rhammell/mdd32-bot/mechanical/export/MDD32_Bot-Chasis.stl

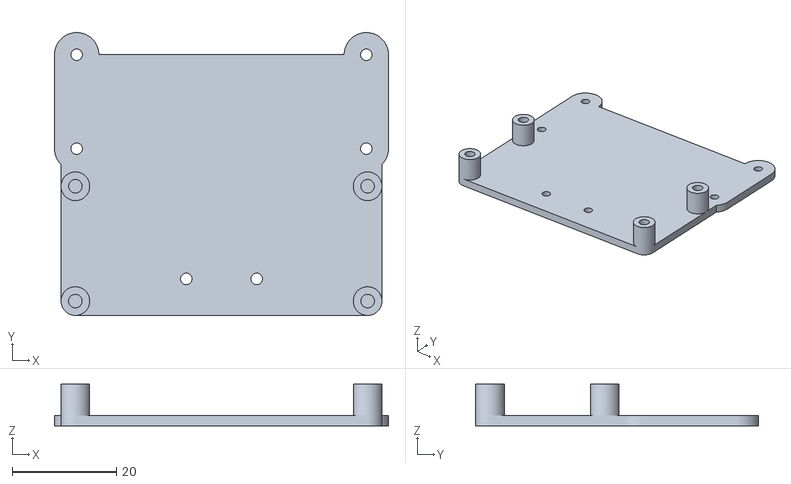
[picture p1: CAD file, 2026-11-05]
mechanical/export/MDD32_Bot-Chasis.stl
64.0 x 54.2 x 8.00
