rhammell/mdd32-bot/mechanical/src/MDD32_Bot.FCStd

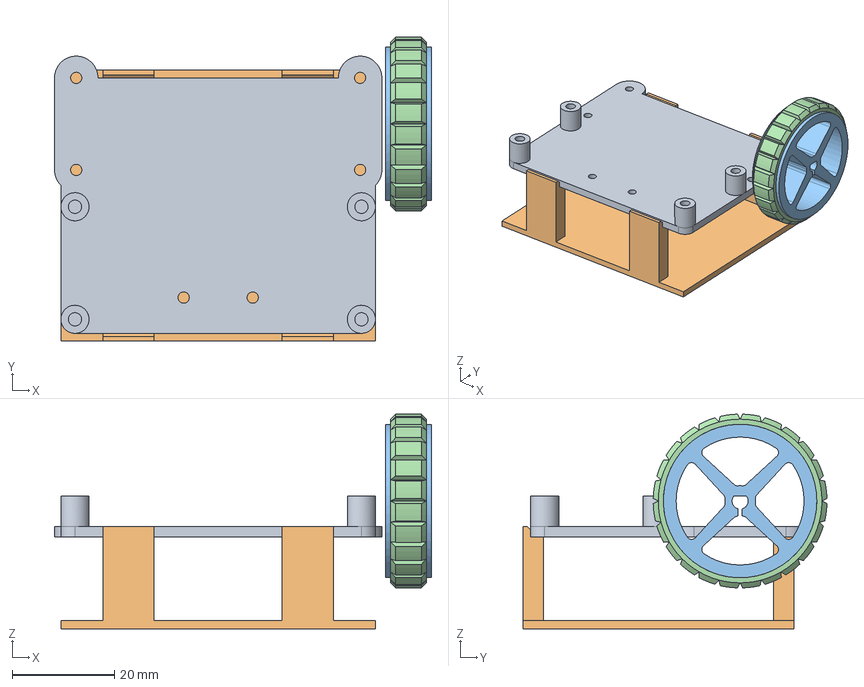
[picture p2: CAD file, 2026-11-05]
mechanical/src/MDD32_Bot.FCStd
73.7 x 59.4 x 42.0 mm
Chasis
Stand
Wheel
Tire
