rhammell/mdd32-bot/mechanical/export/MDD32_Bot-Stand.stl

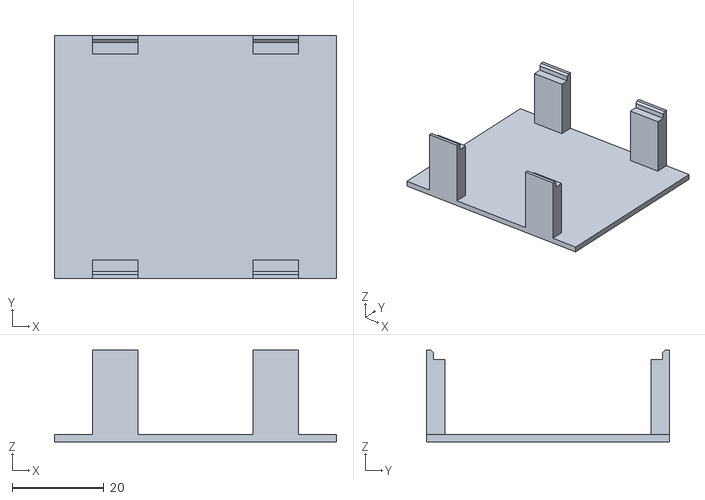
[picture p3: CAD file, 2026-11-05]
mechanical/export/MDD32_Bot-Stand.stl
61.5 x 52.9 x 20.0
