rhammell/mdd32-bot/mechanical/export/MDD32_Bot-Tire.stl

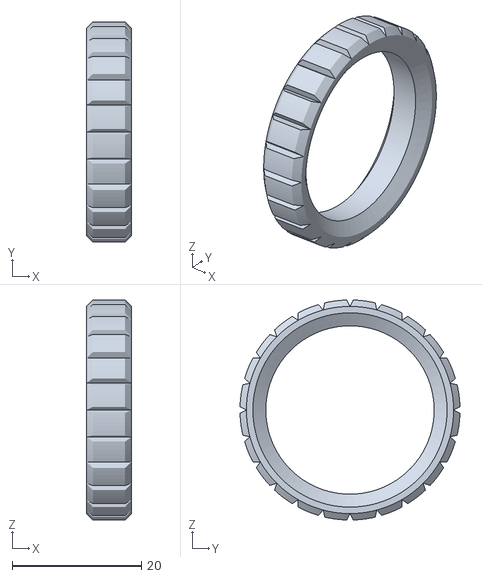
[picture p4: CAD file, 2026-11-05]
mechanical/export/MDD32_Bot-Tire.stl
7.00 x 34.0 x 34.0
