rhammell/mdd32-bot/mechanical/export/MDD32_Bot-Wheel.stl

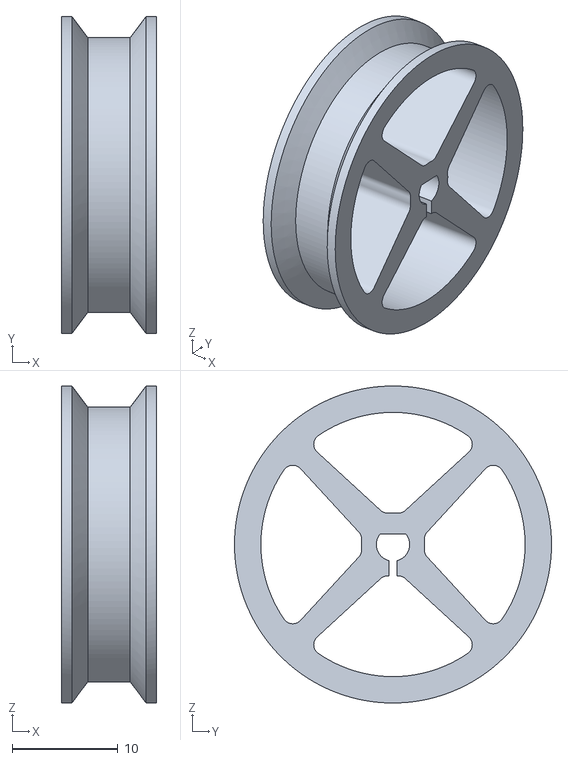
[picture p5: CAD file, 2026-11-05]
mechanical/export/MDD32_Bot-Wheel.stl
9.00 x 30.0 x 30.0
