rhammell/mdd32-bot/firmware/MDD32_Bot/src/drive/MDD32_Drive.cpp

#include "MDD32_Drive.h"

// =============================================================================
// MDD32_Drive Implementation
// =============================================================================

bool MDD32_Drive::begin() {
    // Enable DRV8833 motor driver by pulling nSLEEP high
    Serial.println("[Drive] Enabling DRV8833...");
    pinMode(DRV_SLEEP, OUTPUT);
    digitalWrite(DRV_SLEEP, HIGH);

    // Initialize left motor controller (motor, encoder, PID)
    Serial.println("[Drive] Initializing left motor controller...");
    if (!initController(_leftController,
                        MOT_LEFT_IN1, MOT_LEFT_IN2, MOT_LEFT_FLIP,
                        MOT_LEFT_ENC_A, MOT_LEFT_ENC_B, MOT_LEFT_ENC_FLIP)) {
        Serial.println("[Drive] Left motor controller init FAILED");
        return false;
    }
    Serial.println("[Drive] Left motor controller init OK");

    // Initialize right motor controller (motor, encoder, PID)
    Serial.println("[Drive] Initializing right motor controller...");
    if (!initController(_rightController,
                        MOT_RIGHT_IN1, MOT_RIGHT_IN2, MOT_RIGHT_FLIP,
                        MOT_RIGHT_ENC_A, MOT_RIGHT_ENC_B, MOT_RIGHT_ENC_FLIP)) {
        Serial.println("[Drive] Right motor controller init FAILED");
        return false;
    }
    Serial.println("[Drive] Right motor controller init OK");

    _wheelSyncKP = WHEEL_SYNC_KP;
    _maxAccelRpmS = MAX_ACCEL_RPM_S;

    return true;
}

void MDD32_Drive::setPIDGains(float kp, float ki, float kd) {
    _leftController.setPIDGains(kp, ki, kd);
    _rightController.setPIDGains(kp, ki, kd);
}

void MDD32_Drive::setWheelSyncKP(float kp) {
    _wheelSyncKP = kp;
}

void MDD32_Drive::setMaxAccel(float rpmPerSec) {
    _maxAccelRpmS = rpmPerSec;
}

bool MDD32_Drive::initController(MDD32_Motor_Controller& controller,
                                  uint8_t in1Pin, uint8_t in2Pin, bool motorFlip,
                                  uint8_t encAPin, uint8_t encBPin, bool encFlip) {
    // Config carries only per-side wiring; PID gains and encoder mode are
    // read from robot_definitions.h inside the controller's begin().
    MotorControllerConfig config = {
        in1Pin, in2Pin, motorFlip,
        encAPin, encBPin, encFlip
    };
    return controller.begin(config);
}

void MDD32_Drive::straight(float speed_cm_s) {
    // Both wheels drive the same direction (translate)
    startMove(speed_cm_s, DriveMode::Straight);
}

void MDD32_Drive::spin(float speed_cm_s) {
    // Wheels drive equal-and-opposite so the robot rotates in place about its
    // center. speed_cm_s is the tangential speed of each wheel; positive
    // spins clockwise (left wheel forward, right wheel backward).
    startMove(speed_cm_s, DriveMode::Spin);
}

void MDD32_Drive::startMove(float speed_cm_s, DriveMode mode) {
    // Constrain the speed to the maximum speed
    speed_cm_s = constrain(speed_cm_s, -MAX_SPEED_CM_S, MAX_SPEED_CM_S);

    // Convert the speed to target RPM (signed). For a straight this is the
    // forward wheel speed; for a spin it is each wheel's tangential speed.
    _targetRPM = (speed_cm_s * 60.0f) / WHEEL_CIRCUMFERENCE_CM;

    // If starting from a stop, reset controllers (PID state and encoder
    // counts) so the balance correction starts from zero
    if (_mode == DriveMode::Idle) {
        _leftController.reset();
        _rightController.reset();
        _commandedRPM = 0;
        // Encoder counts were just cleared, so realign the odometry delta
        // trackers. The cumulative distance is intentionally left untouched.
        _lastLeftCount = 0;
        _lastRightCount = 0;
        _lastUpdateTime = micros();
    }

    // Selects the wheel pattern applied in update()
    _mode = mode;
}

void MDD32_Drive::stop() {
    // Immediately stop both motors and go idle
    _targetRPM = 0;
    _commandedRPM = 0;
    _mode = DriveMode::Idle;
    _leftController.stop();
    _rightController.stop();
}

void MDD32_Drive::update() {
    // Nothing to do while idle
    if (_mode == DriveMode::Idle) return;

    // Get the current time and the elapsed time
    uint32_t now = micros();
    uint32_t elapsed = now - _lastUpdateTime;

    // Skip if the minimum interval hasn't passed
    if (elapsed < DRIVE_UPDATE_INTERVAL_US) return;

    // Update the last update time
    _lastUpdateTime = now;

    // Convert the elapsed time to seconds
    float dt = elapsed / 1e6f;

    // Accumulate odometry from the centerline (average) wheel displacement.
    // Skip spins: their residual doesn't cancel under abs and would drift the
    // total. Always refresh baselines so a spin->straight delta stays correct.
    int64_t leftCount = _leftController.getEncoderCount();
    int64_t rightCount = _rightController.getEncoderCount();
    if (_mode != DriveMode::Spin) {
        float centerTicks = ((leftCount - _lastLeftCount)
                           + (rightCount - _lastRightCount)) / 2.0f;
        _distanceCm += fabsf(centerTicks) / TICKS_PER_CM;
    }
    _lastLeftCount = leftCount;
    _lastRightCount = rightCount;

    // Ramp the commanded RPM toward the target at the acceleration limit.
    // _maxAccelRpmS <= 0 disables ramping (snap straight to target).
    float maxDelta = _maxAccelRpmS * dt;
    if (maxDelta <= 0.0f) {
        _commandedRPM = _targetRPM;
    } else {
        _commandedRPM += constrain(_targetRPM - _commandedRPM, -maxDelta, maxDelta);
    }

    // Proportional wheel-sync correction, applied on top of the ramped command
    // (not slewed by the ramp). _wheelSyncKP = 0 disables it. 
    if (_mode == DriveMode::Spin) {
        // Spin: wheels run opposite, so counts should sum to 0 (+ = clockwise).
        float tickError = (float)(leftCount + rightCount);
        float correction = _wheelSyncKP * tickError;
        _leftController.setRPM(_commandedRPM - correction);
        _rightController.setRPM(-_commandedRPM - correction);
    } else {
        // Straight: wheels run together, so counts should stay matched (diff 0).
        float tickError = (float)(leftCount - rightCount);
        float correction = _wheelSyncKP * tickError;
        _leftController.setRPM(_commandedRPM - correction);
        _rightController.setRPM(_commandedRPM + correction);
    }

    // Run the PID controllers to compute and apply PWM outputs
    _leftController.update(dt);
    _rightController.update(dt);
}

bool MDD32_Drive::isMoving() const {
    // Return true if the drive is moving, false otherwise
    return _mode != DriveMode::Idle;
}

DriveTelemetry MDD32_Drive::getTelemetry() const {
    // Return the current motor telemetry for both sides of the drive
    return {
        _leftController.getRPM(),
        _leftController.getPWM(),
        _rightController.getRPM(),
        _rightController.getPWM(),
        _leftController.getEncoderCount(),
        _rightController.getEncoderCount()
    };
}

float MDD32_Drive::getDistance() const {
    // Return the cumulative straight-line distance, in cm, driven since power-on
    return _distanceCm;
}

void MDD32_Drive::resetDistance() {
    // Zero the odometer; does not affect motor/encoder state
    _distanceCm = 0.0f;
}
