rhammell/mdd32-bot/(commit log)

2026-10-17 Update stand
    [MDD32_Bot-Stand.stl, MDD32_Bot.FCStd]
2026-10-21 Fix tuning sketch defaults and docs; add FF placeholder note
    [2_PIDTuning.ino, 3_WheelSyncTuning.ino, 4_DistanceTuning.ino, robot_definitions.h]
2026-11-01 Remove velocity feedforward; renumber tuning sketches
2026-11-05 Resize chassis and wheel size (34mm tire/wheel diameter)
    [MDD32_Bot-Chasis.stl, MDD32_Bot-Stand.stl, MDD32_Bot-Tire.stl, MDD32_Bot-Wheel.stl, MDD32_Bot.FCStd]
2026-11-05 Lower MAX_SPEED_CM_S to 10 cm/s for 34mm wheels; add MaxSpeedTest and StepResponseTest
2026-11-06 Update ticks-per-cm comment in WheelSyncTuning for 34mm wheels
2026-11-06 Set PIDTuning default drive speed to 6 cm/s
2026-11-06 Retune PID gains to KP 4, KI 22 for faster speed settling
2026-11-08 Enhance PID tuning instructions
